techstudycell/Arduino-IoT-Cloud-Project-with-ESP8266-Arduino/Picture/arduino iot cloud tutorial pic-2.jpg

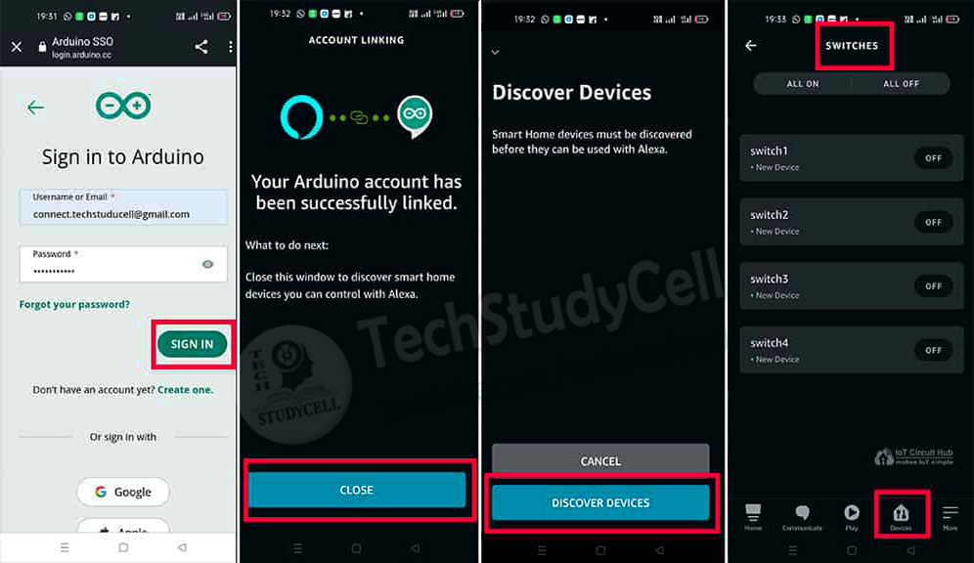
Picture/arduino iot cloud tutorial pic-2.jpg
