techstudycell/Arduino-IoT-Cloud-Project-with-ESP8266-Arduino/Circuit/Circuit Arduino IoT Project Pic1.png

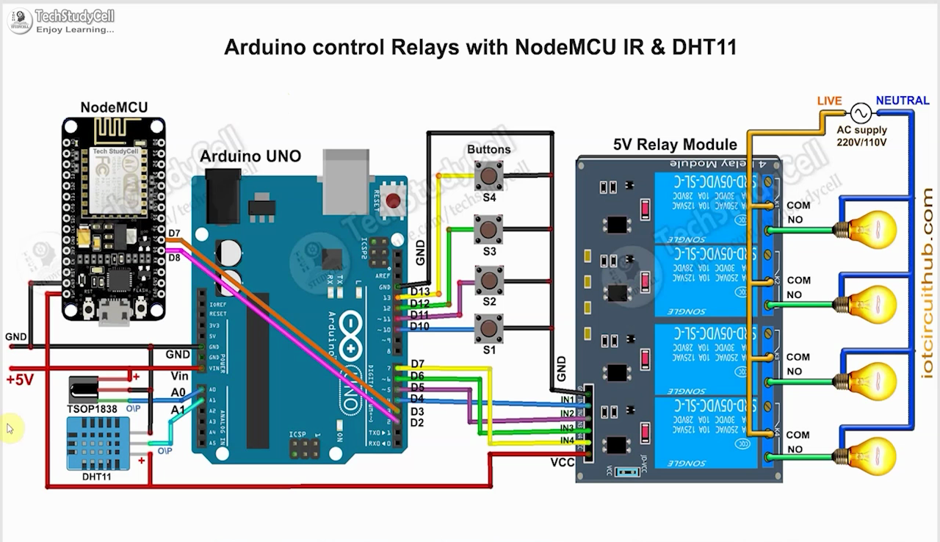
Circuit/Circuit Arduino IoT Project Pic1.png
