techstudycell/Arduino-IoT-Cloud-Project-with-ESP8266-Arduino/Picture/arduino iot cloud dashboard 4.png

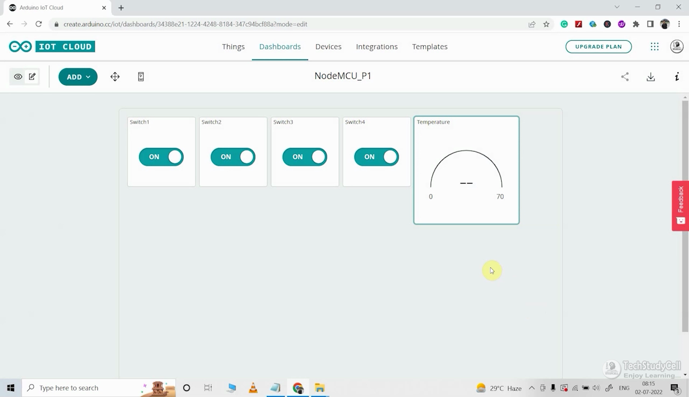
Picture/arduino iot cloud dashboard 4.png
