techstudycell/Arduino-IoT-Cloud-Project-with-ESP8266-Arduino/Picture/Arduino IoT cloud Varriable.png

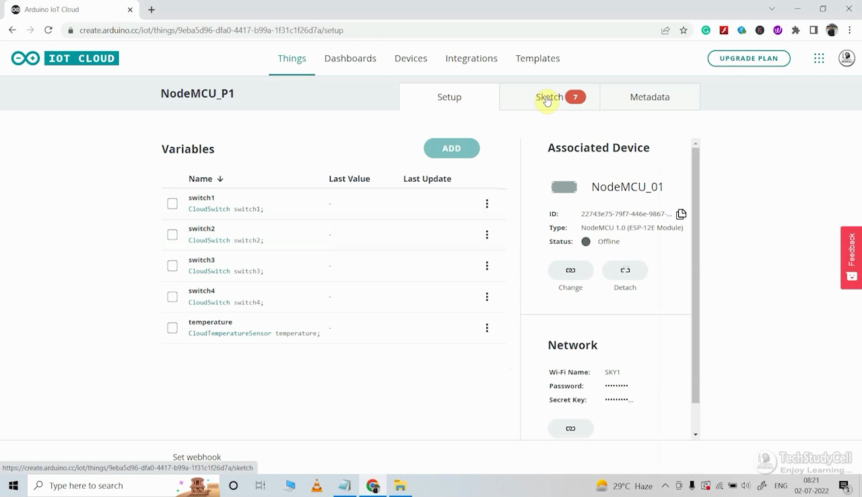
Picture/Arduino IoT cloud Varriable.png
