techstudycell/Arduino-IoT-Cloud-Project-with-ESP8266-Arduino/Picture/Arduino IoT Project Pic2.png

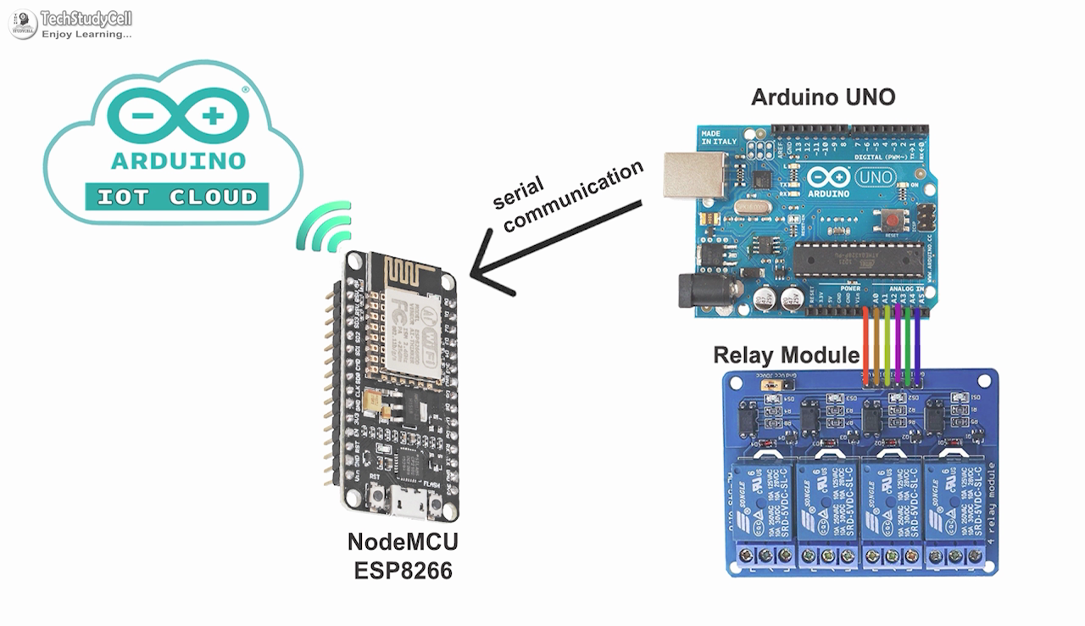
Picture/Arduino IoT Project Pic2.png
