techstudycell/Arduino-IoT-Cloud-Project-with-ESP8266-Arduino/Picture/Arduino IoT Project Pic7.png

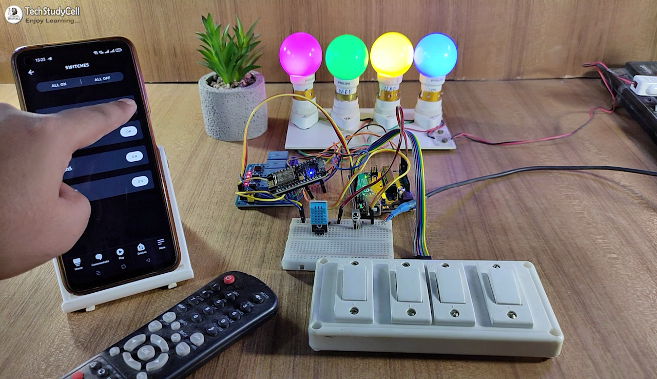
Picture/Arduino IoT Project Pic7.png
