techstudycell/Arduino-IoT-Cloud-Project-with-ESP8266-Arduino/Picture/Arduino IoT Project Pic8.png

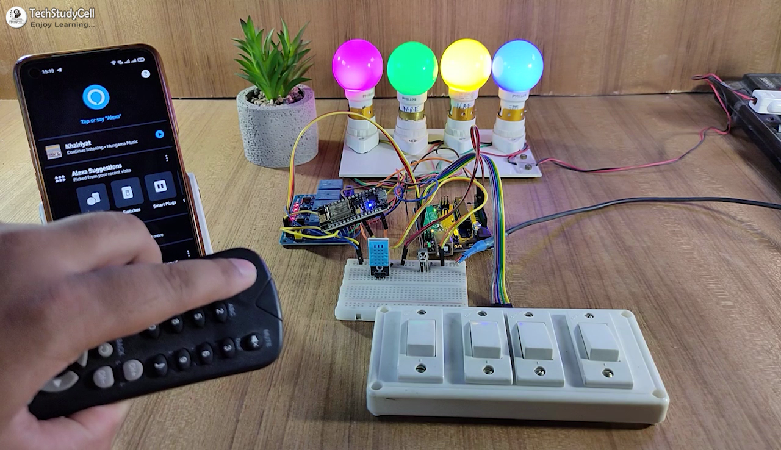
Picture/Arduino IoT Project Pic8.png
