techstudycell/Arduino-IoT-Cloud-Project-with-ESP8266-Arduino/Picture/Code for Arduino.png

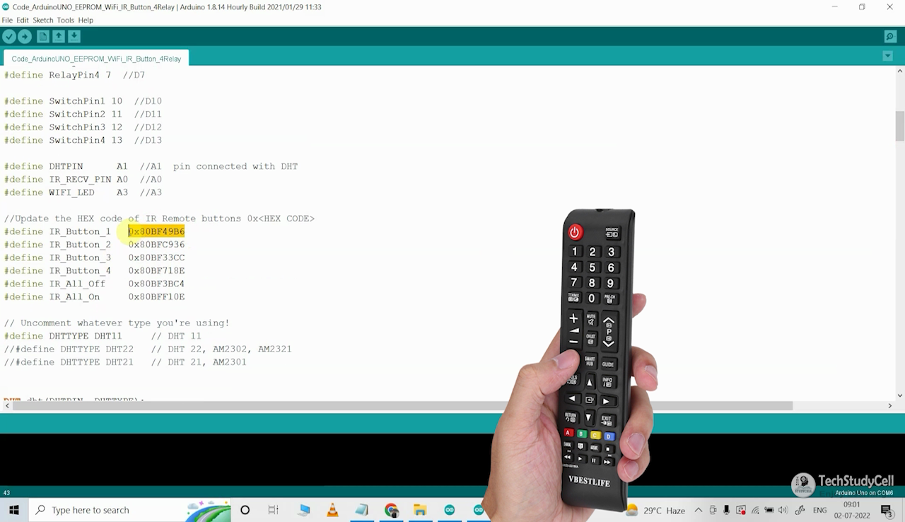
Picture/Code for Arduino.png
