techstudycell/Arduino-IoT-Cloud-Project-with-ESP8266-Arduino/Picture/Code for NodeMCU.JPG

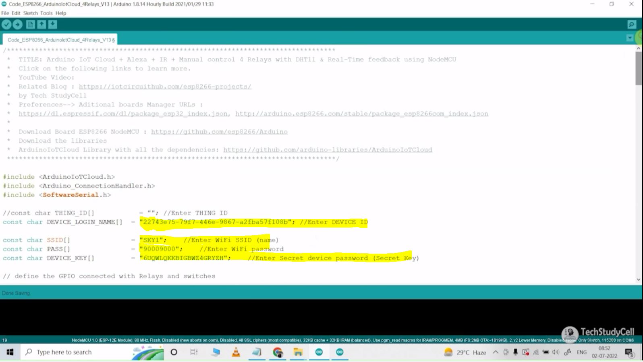
Picture/Code for NodeMCU.JPG
