techstudycell/Arduino-IoT-Cloud-Project-with-ESP8266-Arduino/Picture/IoT Project PCB 1.png

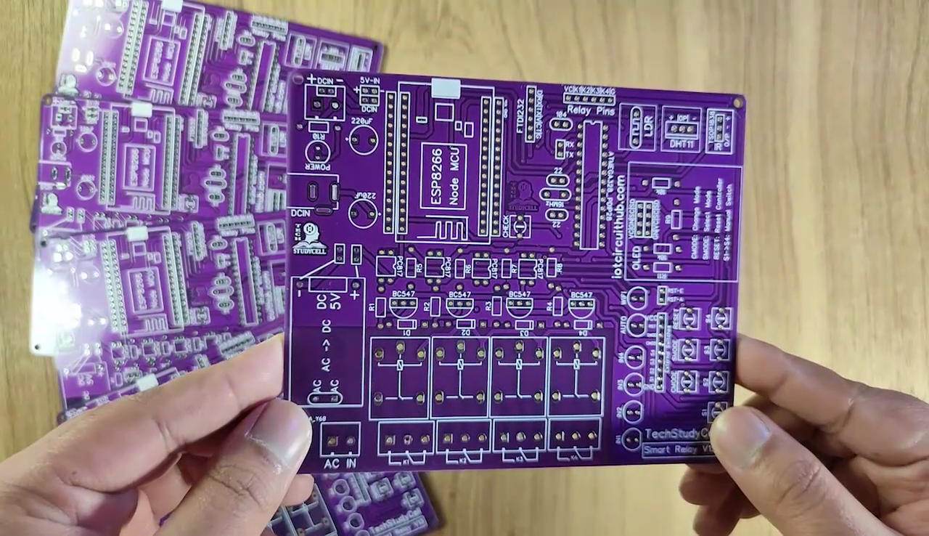
Picture/IoT Project PCB 1.png
