techstudycell/Arduino-IoT-Cloud-Project-with-ESP8266-Arduino/Picture/IoT Project PCB 3.png

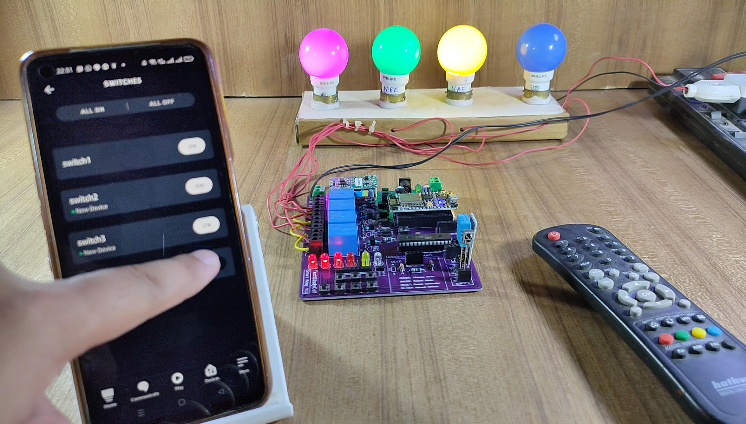
Picture/IoT Project PCB 3.png
